AuthorsWisdom/ssp-wedge-keyboard/keyboard-pcb/renders/ssp-wedge-kb-bottom.png

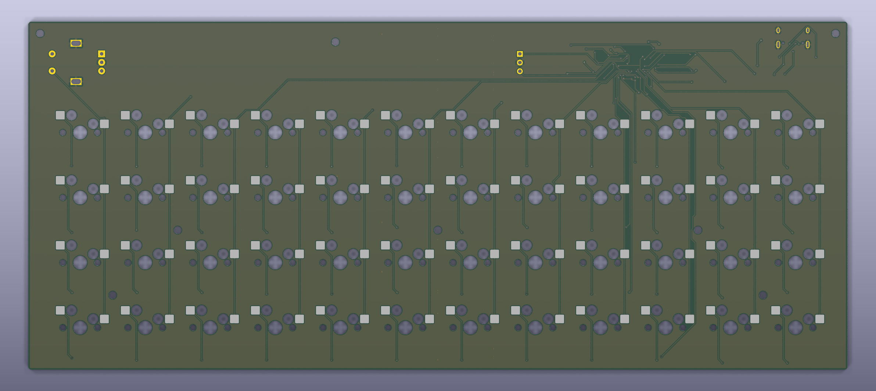
keyboard-pcb/renders/ssp-wedge-kb-bottom.png
