AuthorsWisdom/ssp-wedge-keyboard/keyboard-pcb/renders/ssp-wedge-kb-top.png

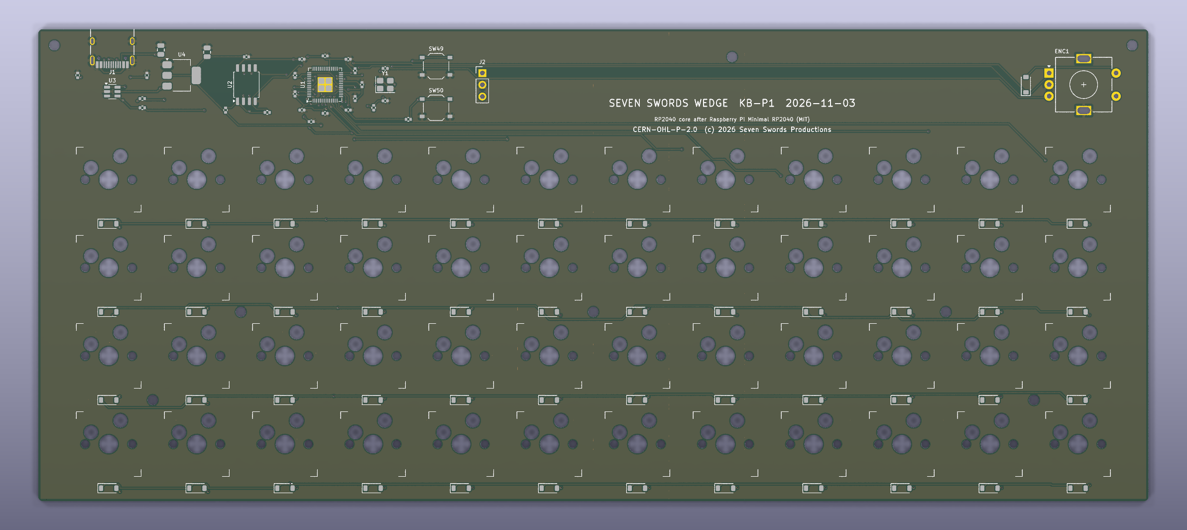
keyboard-pcb/renders/ssp-wedge-kb-top.png
