AuthorsWisdom/ssp-wedge-keyboard/keyboard-pcb/fab/bom-jlc.csv

Comment | Designator | Footprint | LCSC Part #
100nF | C1,C2,C3,C4,C5,C6,C7,C8,C11,C12,C13 | C_0402_1005Metric | C1525
1uF | C9,C10 | C_0402_1005Metric | C52923
33pF | C14,C15 | C_0402_1005Metric | C1562
10uF | C16,C17 | C_0805_2012Metric | C15850
1N4148W | D1,D2,D3,D4,D5,D6,D7,D8,D9,D10,D11,D12,D13,D14,D15,D16,D17,D18,D19,D20,D21,D22,D23,D24,D25,D26,D27,D28,D29,D30,D31,D32,D33,D34,D35,D36,D37,D38,D39,D40,D41,D42,D43,D44,D45,D46,D47,D48,D49 | D_SOD-123 | C81598
USB-C | J1 | USB_C_Receptacle_HRO_TYPE-C-31-M-12 | C165948
10k | R1,R3 | R_0402_1005Metric | C25744
1k | R2,R4 | R_0402_1005Metric | C11702
5.1k | R5,R6 | R_0402_1005Metric | C25905
27R | R7,R8 | R_0402_1005Metric | C25100
BOOT | SW49 | SW_Push_1P1T_XKB_TS-1187A | C318884
RESET | SW50 | SW_Push_1P1T_XKB_TS-1187A | C318884
RP2040 | U1 | QFN-56-1EP_7x7mm_P0.4mm_EP3.2x3.2mm | C2040
W25Q128JVSIQ | U2 | SOIC-8_5.3x5.3mm_P1.27mm | C97521
USBLC6-2SC6 | U3 | SOT-23-6 | C7519
AMS1117-3.3 | U4 | SOT-223-3_TabPin2 | C6186
12MHz | Y1 | Crystal_SMD_3225-4Pin_3.2x2.5mm | C9002
