AuthorsWisdom/ssp-wedge-keyboard/keyboard-pcb/mech/ssp-wedge-kb-outline.dxf

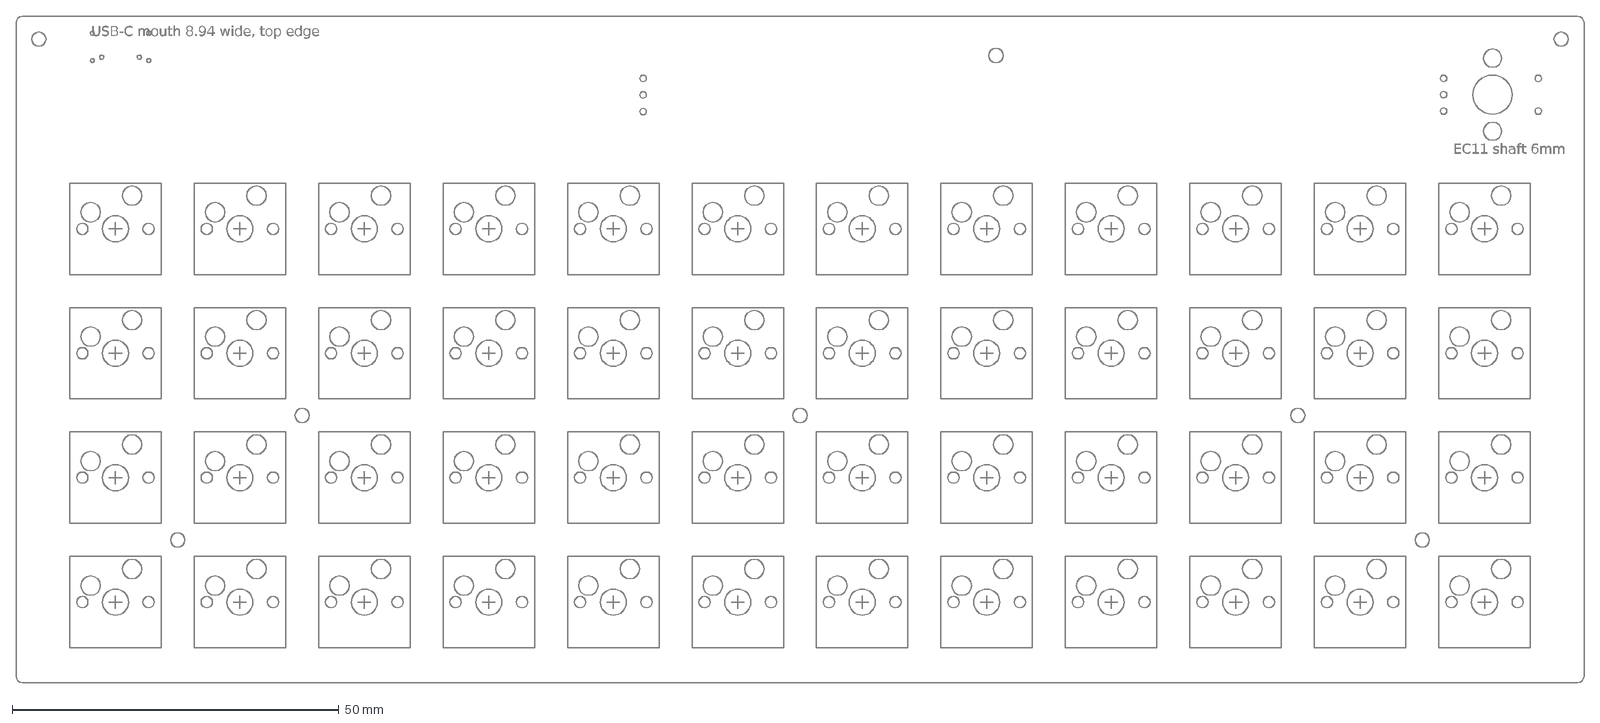
[picture p3: CAD file, 2026-11-03]
keyboard-pcb/mech/ssp-wedge-kb-outline.dxf
USB-C mouth 8.94 wide, top edge
EC11 shaft 6mm
