AuthorsWisdom/ssp-wedge-keyboard/keyboard-pcb/reports/schematic.pdf

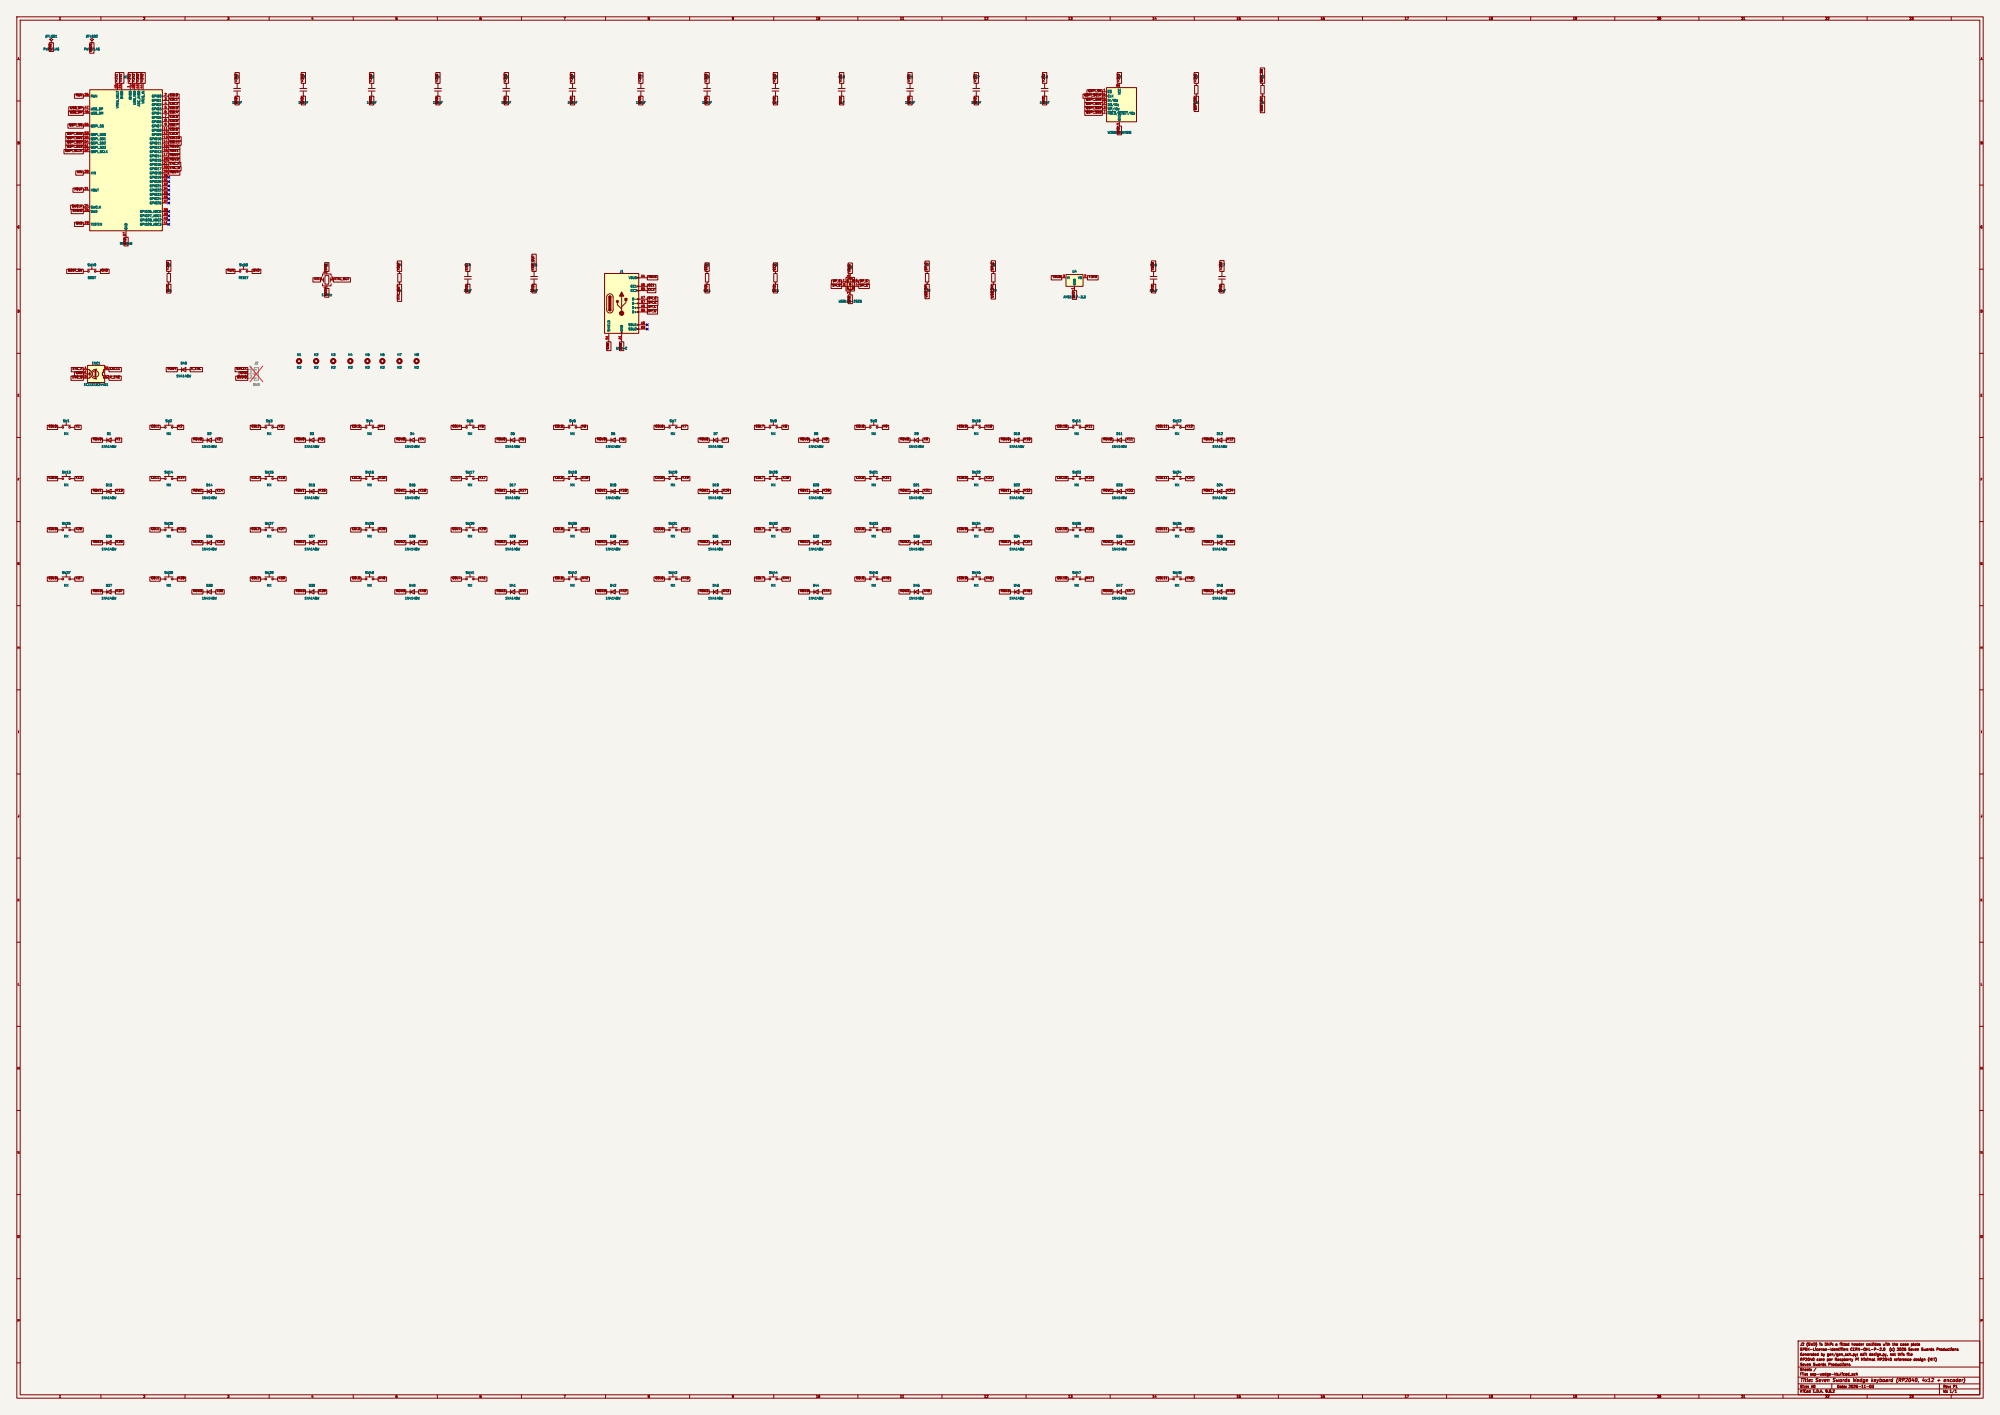
[picture p4: page 1]
