AuthorsWisdom/ssp-wedge-keyboard/(list of files, drawings)

Other design files:
keyboard-pcb/route/ssp-wedge-kb.dsn
