AuthorsWisdom/ssp-wedge-keyboard/keyboard-pcb/ssp-wedge-kb.kicad_pcb

## KiCad design keyboard-pcb/ssp-wedge-kb.kicad_pcb (2026-11-03)

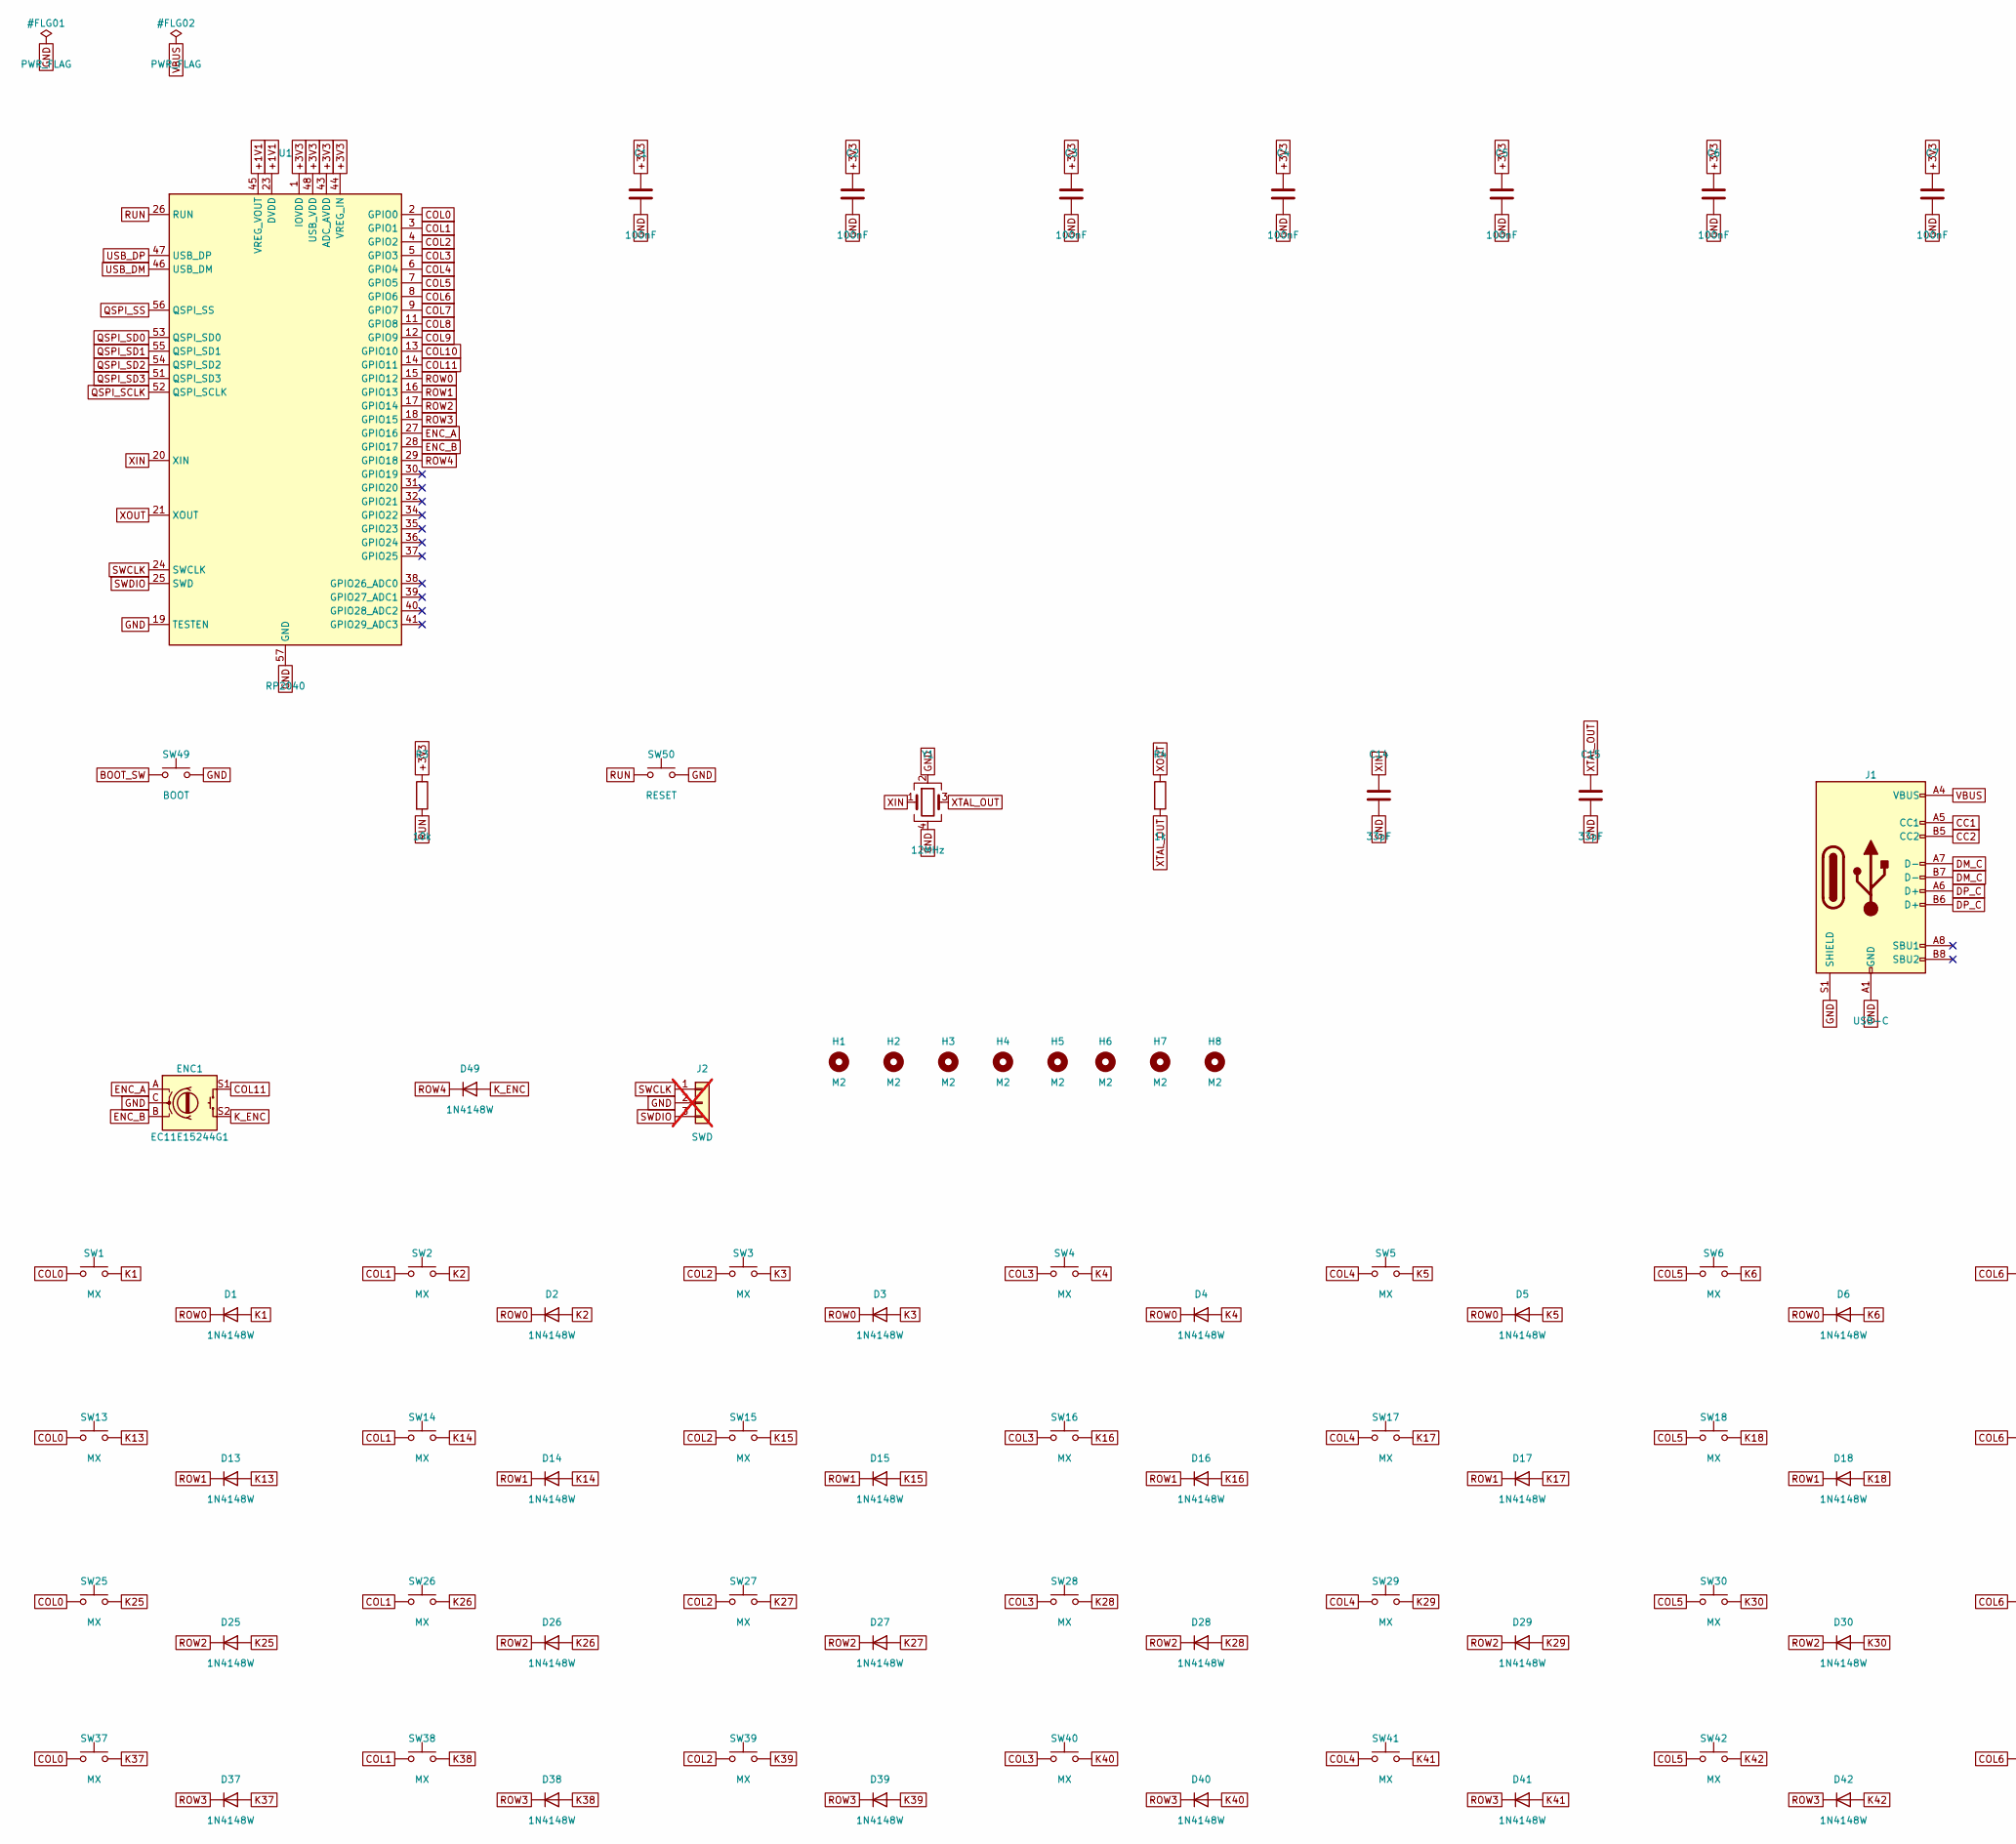
[picture p5: schematic ssp-wedge-kb.kicad_sch, Seven Swords Wedge keyboard (RP2040, 4x12 + encoder), part in row 1, column 1]

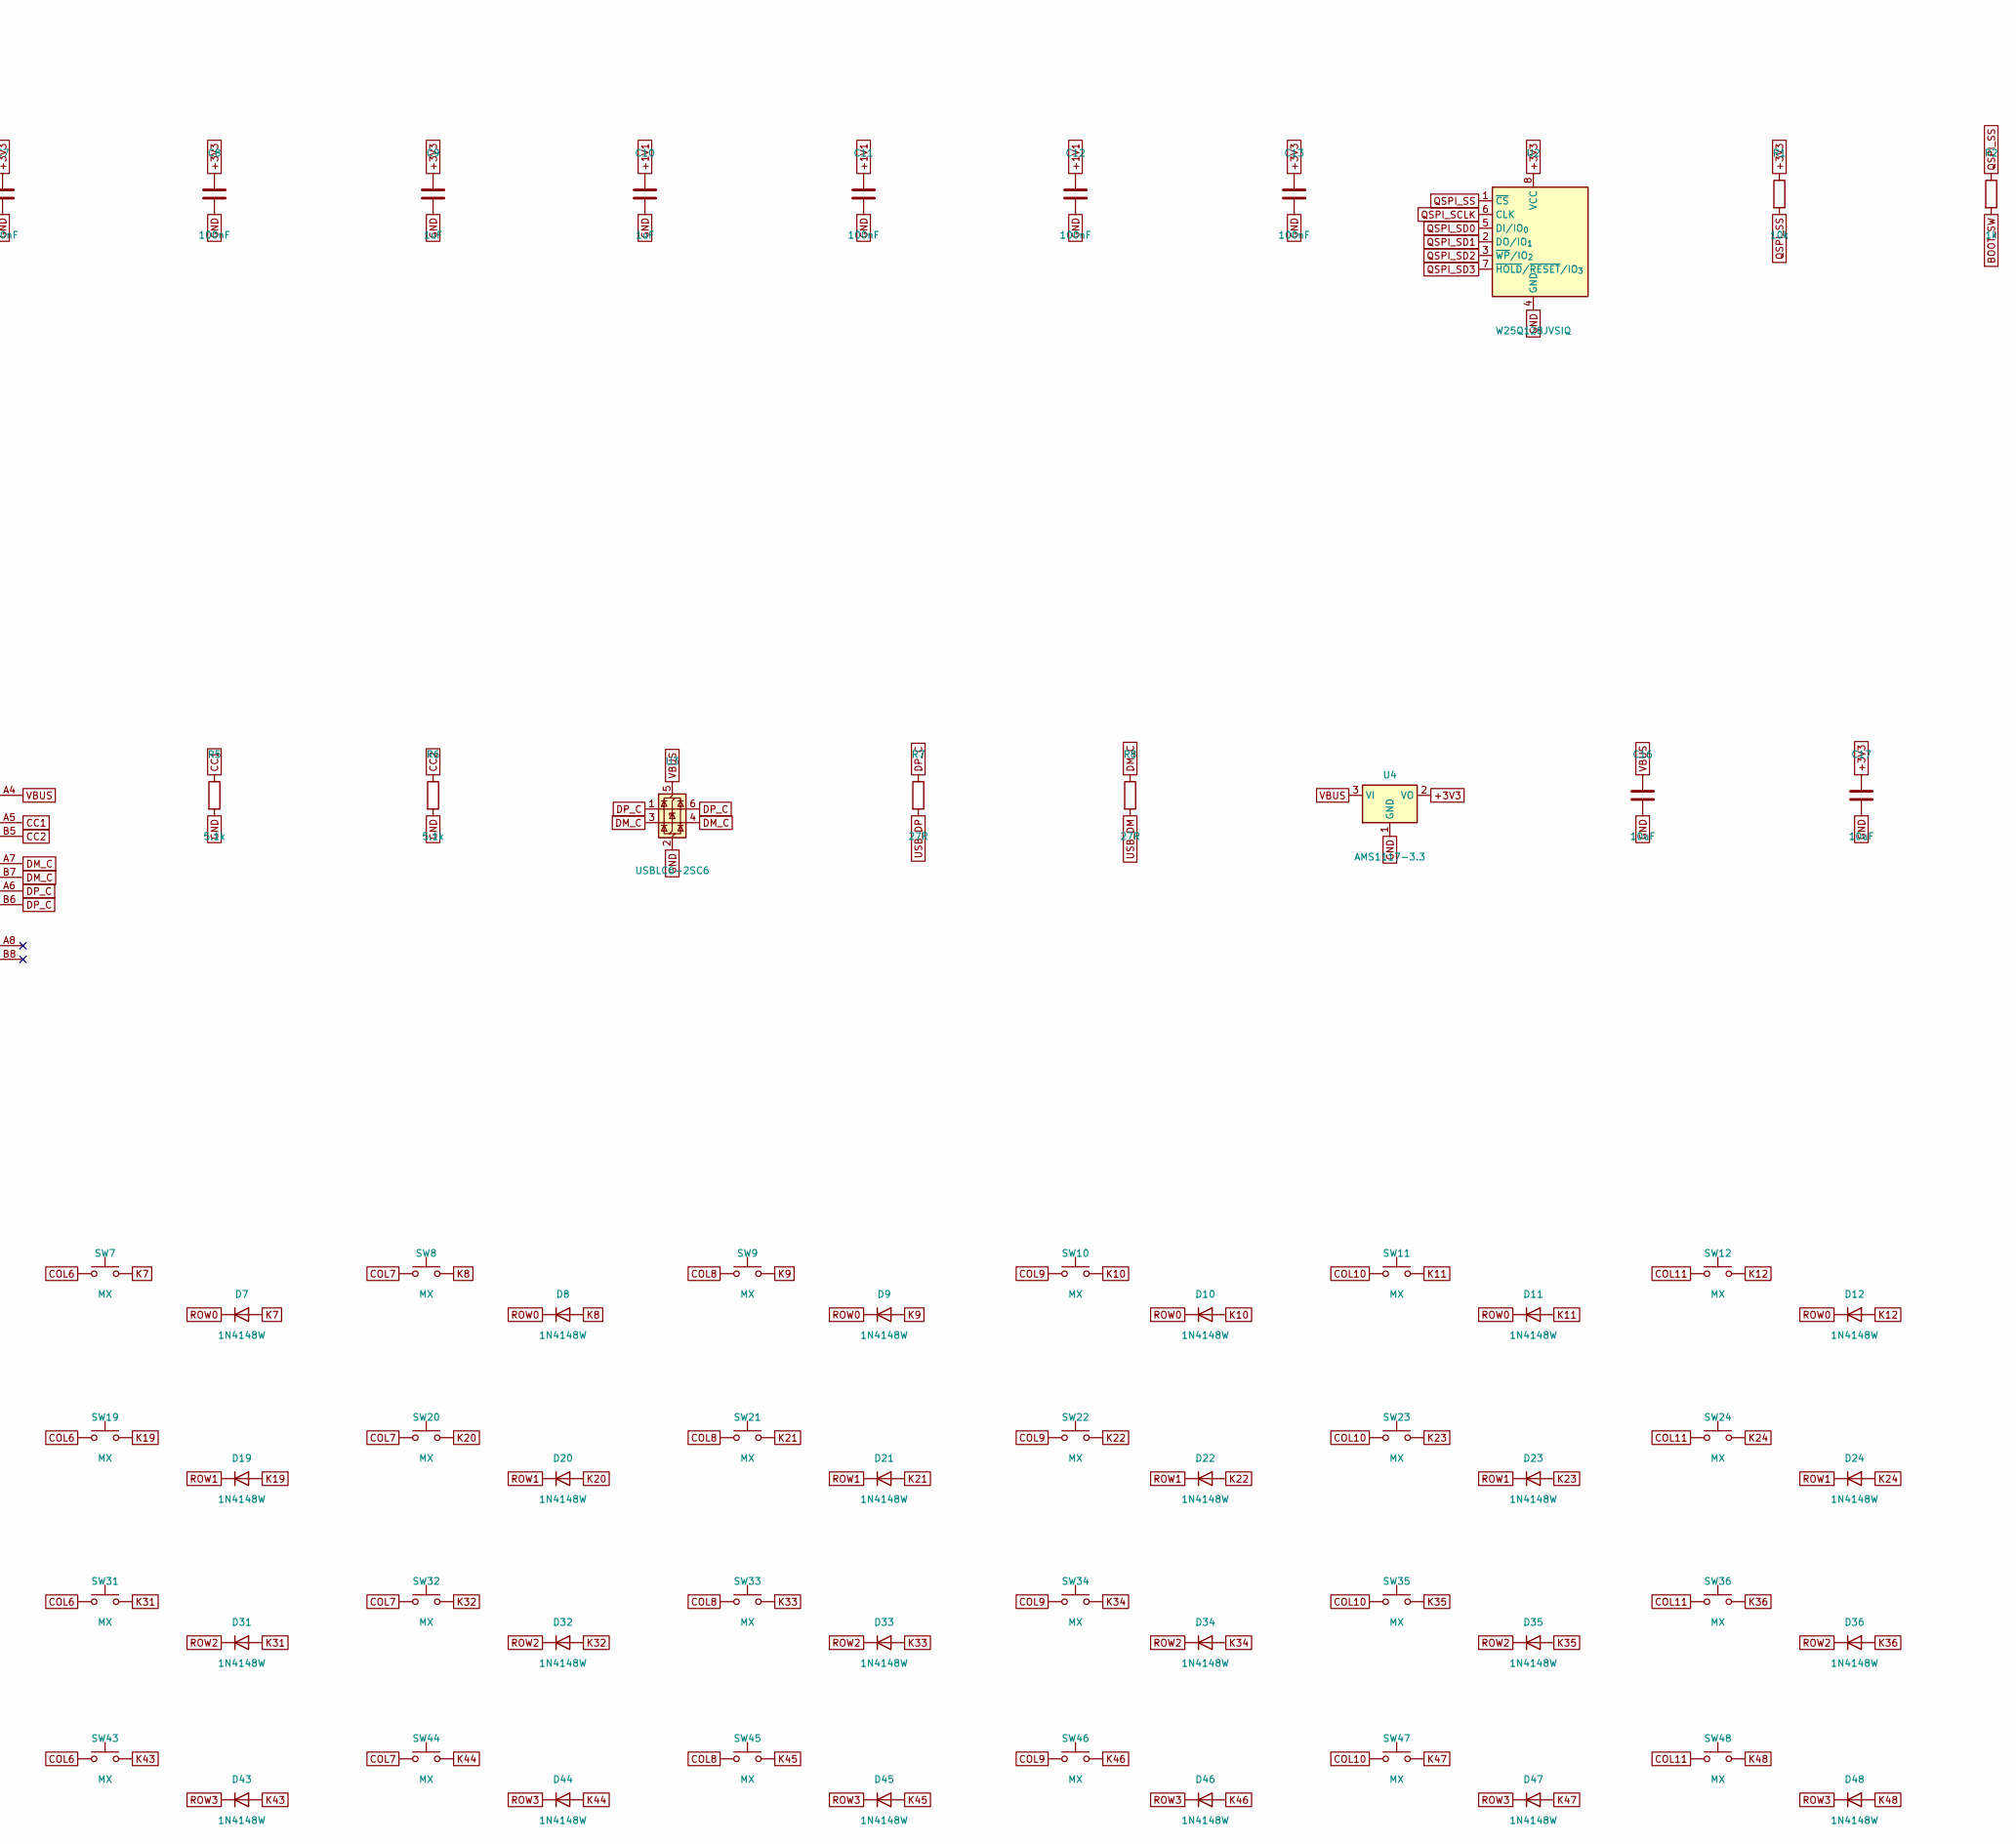
[picture p6: schematic ssp-wedge-kb.kicad_sch, Seven Swords Wedge keyboard (RP2040, 4x12 + encoder), part in row 1, column 2]

Parts:
C1, C2, C3, C4, C5, C6, C7, C8, C11, C12, C13: 100nF; C_0402_1005Metric; LCSC C1525
C9, C10: 1uF; C_0402_1005Metric; LCSC C52923
C14, C15: 33pF; C_0402_1005Metric; LCSC C1562
C16, C17: 10uF; C_0805_2012Metric; LCSC C15850
D1, D2, D3, D4, D5, D6, D7, D8, D9, D10, D11, D12, D13, D14, D15, D16, D17, D18, D19, D20, D21, D22, D23, D24, D25, D26, D27, D28, D29, D30, D31, D32, D33, D34, D35, D36, D37, D38, D39, D40, D41, D42, D43, D44, D45, D46, D47, D48, D49: 1N4148W; D_SOD-123; LCSC C81598
ENC1: EC11E15244G1; RotaryEncoder_Alps_EC11E-Switch_Vertical_H20mm; LCSC C370970
H1, H2, H3, H4, H5, H6, H7, H8: M2; MountingHole_2.2mm_M2
J1: USB-C; USB_C_Receptacle_HRO_TYPE-C-31-M-12; LCSC C165948
J2: SWD; PinHeader_1x03_P2.54mm_Vertical; not fitted
R1, R3: 10k; R_0402_1005Metric; LCSC C25744
R2, R4: 1k; R_0402_1005Metric; LCSC C11702
R5, R6: 5.1k; R_0402_1005Metric; LCSC C25905
R7, R8: 27R; R_0402_1005Metric; LCSC C25100
SW1, SW2, SW3, SW4, SW5, SW6, SW7, SW8, SW9, SW10, SW11, SW12, SW13, SW14, SW15, SW16, SW17, SW18, SW19, SW20, SW21, SW22, SW23, SW24, SW25, SW26, SW27, SW28, SW29, SW30, SW31, SW32, SW33, SW34, SW35, SW36, SW37, SW38, SW39, SW40, SW41, SW42, SW43, SW44, SW45, SW46, SW47, SW48: MX; SW_MX_Hotswap_Kailh_1.00u; LCSC C5156480
SW49: BOOT; SW_Push_1P1T_XKB_TS-1187A; LCSC C318884
SW50: RESET; SW_Push_1P1T_XKB_TS-1187A; LCSC C318884
U1: RP2040; QFN-56-1EP_7x7mm_P0.4mm_EP3.2x3.2mm; LCSC C2040
U2: W25Q128JVSIQ; SOIC-8_5.3x5.3mm_P1.27mm; LCSC C97521
U3: USBLC6-2SC6; SOT-23-6; LCSC C7519
U4: AMS1117-3.3; SOT-223-3_TabPin2; LCSC C6186
Y1: 12MHz; Crystal_SMD_3225-4Pin_3.2x2.5mm; LCSC C9002

Connections:
+1V1: C10.1, C11.1, C12.1, U1.23 (DVDD), U1.45 (VREG_VOUT), U1.50 (DVDD)
+3V3: C1.1, C2.1, C3.1, C4.1, C5.1, C6.1, C7.1, C8.1, C9.1, C13.1, C17.1, R1.1, R3.1, U1.1 (IOVDD), U1.10 (IOVDD), U1.22 (IOVDD), U1.33 (IOVDD), U1.42 (IOVDD), U1.43 (ADC_AVDD), U1.44 (VREG_IN), U1.48 (USB_VDD), U1.49 (IOVDD), U2.8 (VCC), U4.2 (VO)
BOOT_SW: R2.2, SW49.1
CC1: J1.A5 (CC1), R5.1
CC2: J1.B5 (CC2), R6.1
COL0: SW1.1, SW13.1, SW25.1, SW37.1, U1.2 (GPIO0)
COL1: SW2.1, SW14.1, SW26.1, SW38.1, U1.3 (GPIO1)
COL2: SW3.1, SW15.1, SW27.1, SW39.1, U1.4 (GPIO2)
COL3: SW4.1, SW16.1, SW28.1, SW40.1, U1.5 (GPIO3)
COL4: SW5.1, SW17.1, SW29.1, SW41.1, U1.6 (GPIO4)
COL5: SW6.1, SW18.1, SW30.1, SW42.1, U1.7 (GPIO5)
COL6: SW7.1, SW19.1, SW31.1, SW43.1, U1.8 (GPIO6)
COL7: SW8.1, SW20.1, SW32.1, SW44.1, U1.9 (GPIO7)
COL8: SW9.1, SW21.1, SW33.1, SW45.1, U1.11 (GPIO8)
COL9: SW10.1, SW22.1, SW34.1, SW46.1, U1.12 (GPIO9)
COL10: SW11.1, SW23.1, SW35.1, SW47.1, U1.13 (GPIO10)
COL11: ENC1.S1, SW12.1, SW24.1, SW36.1, SW48.1, U1.14 (GPIO11)
DM_C: J1.A7 (D-), J1.B7 (D-), R8.1, U3.3 (I/O2), U3.4 (I/O2)
DP_C: J1.A6 (D+), J1.B6 (D+), R7.1, U3.1 (I/O1), U3.6 (I/O1)
ENC_A: ENC1.A, U1.27 (GPIO16)
ENC_B: ENC1.B, U1.28 (GPIO17)
GND: C1.2, C2.2, C3.2, C4.2, C5.2, C6.2, C7.2, C8.2, C9.2, C10.2, C11.2, C12.2, C13.2, C14.2, C15.2, C16.2, C17.2, ENC1.C, ENC1.MP, J1.A1 (GND), J1.A12 (GND), J1.B1 (GND), J1.B12 (GND), J1.S1 (SHIELD), J2.2, R5.2, R6.2, SW49.2, SW50.2, U1.19 (TESTEN), U1.57 (GND), U2.4 (GND), U3.2 (GND), U4.1 (GND), Y1.2, Y1.4
K1: D1.2 (A), SW1.2
K2: D2.2 (A), SW2.2
K3: D3.2 (A), SW3.2
K4: D4.2 (A), SW4.2
K5: D5.2 (A), SW5.2
K6: D6.2 (A), SW6.2
K7: D7.2 (A), SW7.2
K8: D8.2 (A), SW8.2
K9: D9.2 (A), SW9.2
K10: D10.2 (A), SW10.2
K11: D11.2 (A), SW11.2
K12: D12.2 (A), SW12.2
K13: D13.2 (A), SW13.2
K14: D14.2 (A), SW14.2
K15: D15.2 (A), SW15.2
K16: D16.2 (A), SW16.2
K17: D17.2 (A), SW17.2
K18: D18.2 (A), SW18.2
K19: D19.2 (A), SW19.2
K20: D20.2 (A), SW20.2
K21: D21.2 (A), SW21.2
K22: D22.2 (A), SW22.2
K23: D23.2 (A), SW23.2
K24: D24.2 (A), SW24.2
K25: D25.2 (A), SW25.2
K26: D26.2 (A), SW26.2
K27: D27.2 (A), SW27.2
K28: D28.2 (A), SW28.2
K29: D29.2 (A), SW29.2
K30: D30.2 (A), SW30.2
K31: D31.2 (A), SW31.2
K32: D32.2 (A), SW32.2
K33: D33.2 (A), SW33.2
K34: D34.2 (A), SW34.2
K35: D35.2 (A), SW35.2
K36: D36.2 (A), SW36.2
K37: D37.2 (A), SW37.2
K38: D38.2 (A), SW38.2
K39: D39.2 (A), SW39.2
K40: D40.2 (A), SW40.2
K41: D41.2 (A), SW41.2
K42: D42.2 (A), SW42.2
K43: D43.2 (A), SW43.2
K44: D44.2 (A), SW44.2
K45: D45.2 (A), SW45.2
K46: D46.2 (A), SW46.2
K47: D47.2 (A), SW47.2
K48: D48.2 (A), SW48.2
K_ENC: D49.2 (A), ENC1.S2
QSPI_SCLK: U1.52 (QSPI_SCLK), U2.6 (CLK)
QSPI_SD0: U1.53 (QSPI_SD0), U2.5 (DI/IO_{0})
QSPI_SD1: U1.55 (QSPI_SD1), U2.2 (DO/IO_{1})
QSPI_SD2: U1.54 (QSPI_SD2), U2.3 (~WP/IO_{2})
QSPI_SD3: U1.51 (QSPI_SD3), U2.7 (~HOLD/~RESET/IO_{3})
QSPI_SS: R1.2, R2.1, U1.56 (QSPI_SS), U2.1 (~CS)
ROW0: D1.1 (K), D2.1 (K), D3.1 (K), D4.1 (K), D5.1 (K), D6.1 (K), D7.1 (K), D8.1 (K), D9.1 (K), D10.1 (K), D11.1 (K), D12.1 (K), U1.15 (GPIO12)
ROW1: D13.1 (K), D14.1 (K), D15.1 (K), D16.1 (K), D17.1 (K), D18.1 (K), D19.1 (K), D20.1 (K), D21.1 (K), D22.1 (K), D23.1 (K), D24.1 (K), U1.16 (GPIO13)
ROW2: D25.1 (K), D26.1 (K), D27.1 (K), D28.1 (K), D29.1 (K), D30.1 (K), D31.1 (K), D32.1 (K), D33.1 (K), D34.1 (K), D35.1 (K), D36.1 (K), U1.17 (GPIO14)
ROW3: D37.1 (K), D38.1 (K), D39.1 (K), D40.1 (K), D41.1 (K), D42.1 (K), D43.1 (K), D44.1 (K), D45.1 (K), D46.1 (K), D47.1 (K), D48.1 (K), U1.18 (GPIO15)
ROW4: D49.1 (K), U1.29 (GPIO18)
RUN: R3.2, SW50.1, U1.26 (RUN)
SWCLK: J2.1, U1.24 (SWCLK)
SWDIO: J2.3, U1.25 (SWD)
USB_DM: R8.2, U1.46 (USB_DM)
USB_DP: R7.2, U1.47 (USB_DP)
VBUS: C16.1, J1.A4 (VBUS), J1.A9 (VBUS), J1.B4 (VBUS), J1.B9 (VBUS), U3.5 (VBUS), U4.3 (VI)
XIN: C14.1, U1.20 (XIN), Y1.1
XOUT: R4.1, U1.21 (XOUT)
XTAL_OUT: C15.1, R4.2, Y1.3

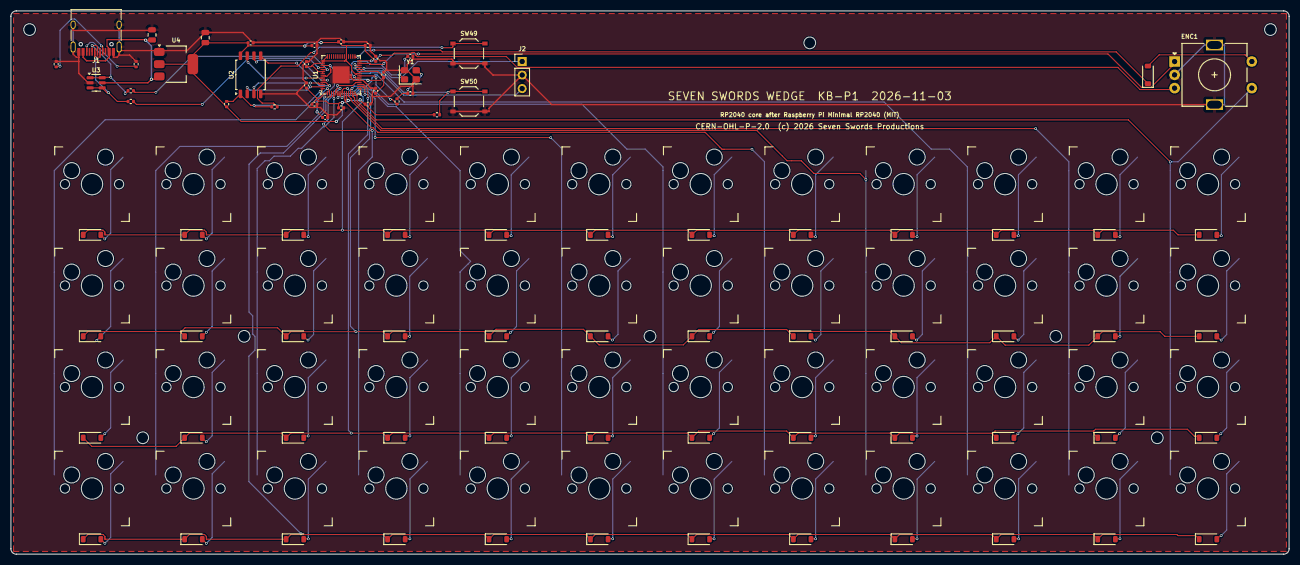
[picture p7: board ssp-wedge-kb.kicad_pcb from above]

Board: 2 copper layers, 240.0 x 102.0 mm, 140 parts (0 on the bottom side), 91 nets.
